Indemsys/Universal3PHalfBridgeController/Photos/Testing_w_motor.jpg

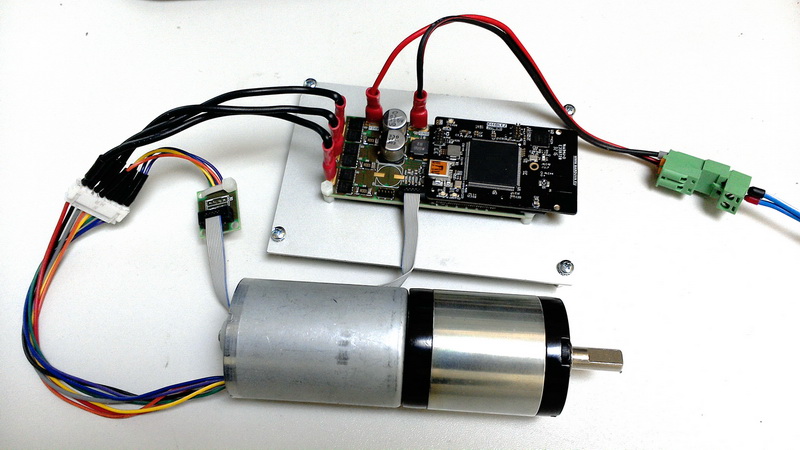
Photos/Testing_w_motor.jpg
