Indemsys/Universal3PHalfBridgeController/Docs/PCB_top.png

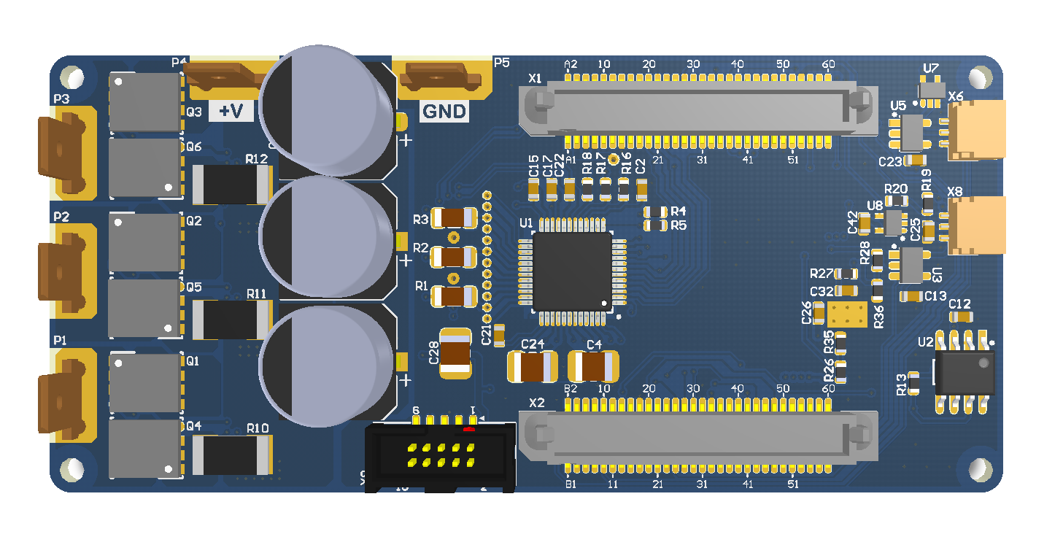
Docs/PCB_top.png
