Indemsys/Universal3PHalfBridgeController/README.md

# Universal3PHalfBridgeController
