Indemsys/Universal3PHalfBridgeController/Docs/PCB_bot.png

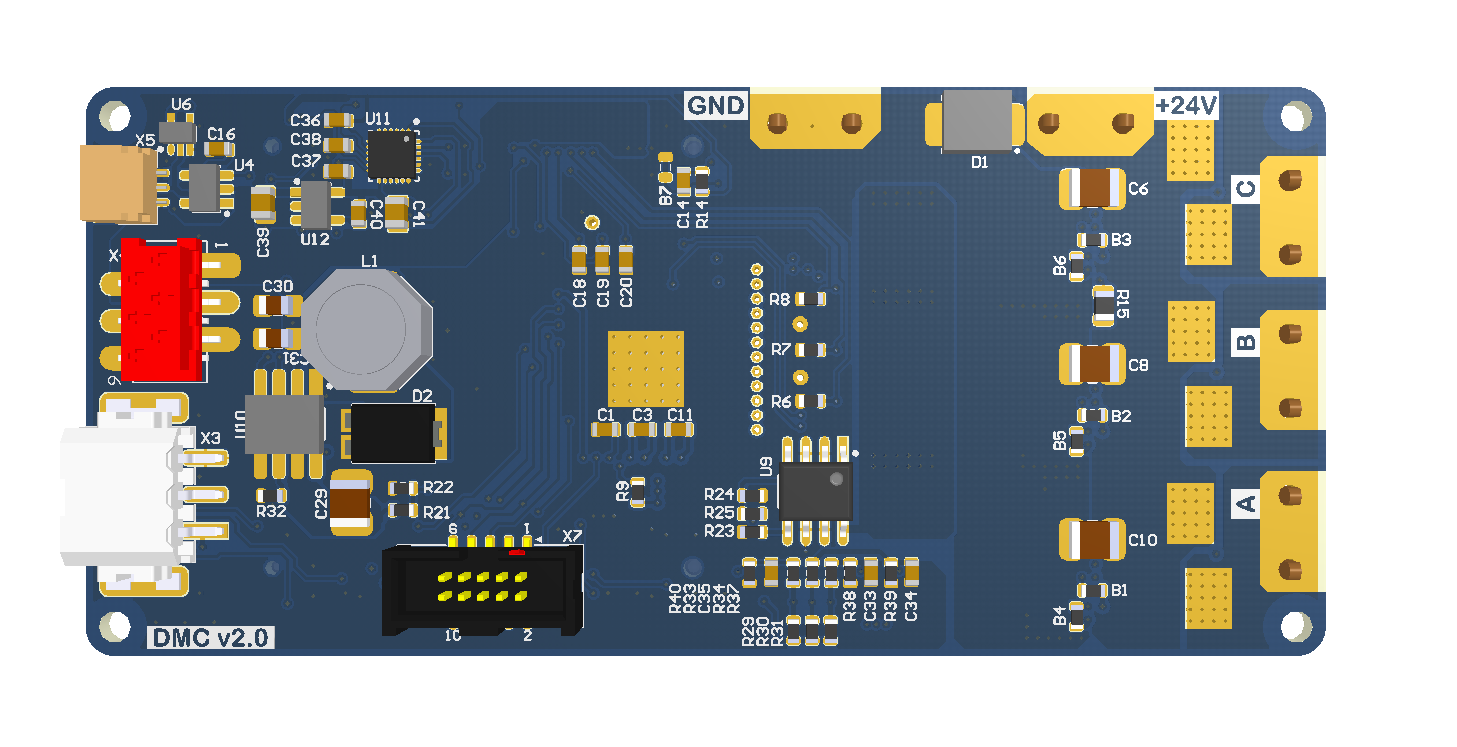
Docs/PCB_bot.png
