Indemsys/Universal3PHalfBridgeController/K66_Firmware/FreeMaster_apps/HTML/RotControl_Pic.jpg

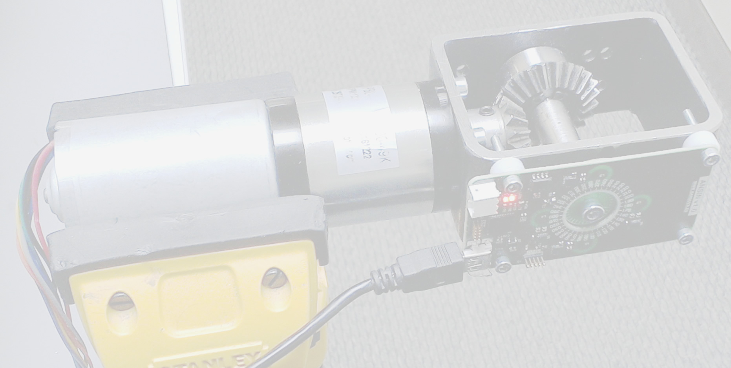
K66_Firmware/FreeMaster_apps/HTML/RotControl_Pic.jpg
