Indemsys/Universal3PHalfBridgeController/K66_Firmware/FreeMaster_apps/HTML/SolenoidControl_pic.jpg

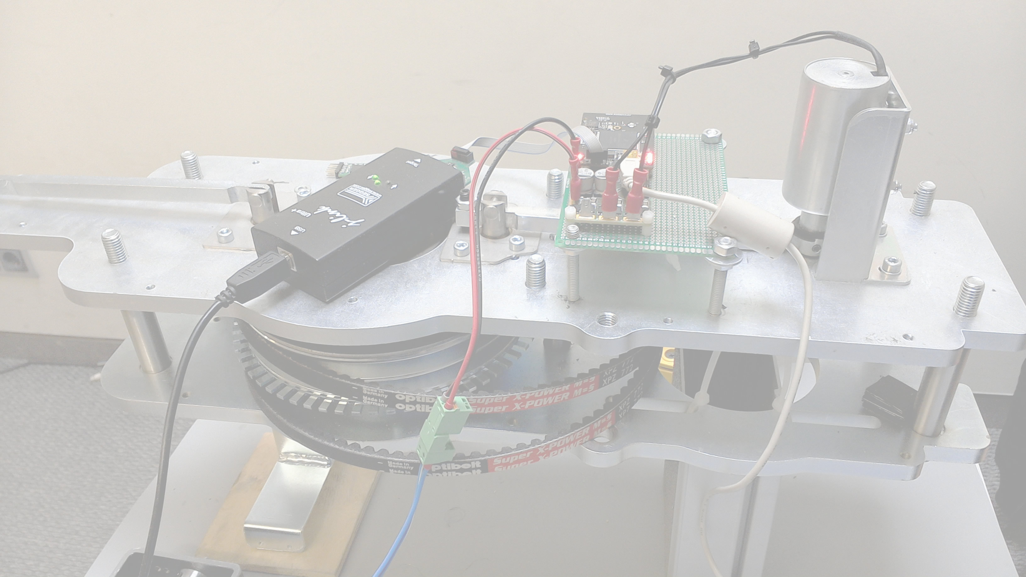
K66_Firmware/FreeMaster_apps/HTML/SolenoidControl_pic.jpg
