Indemsys/Universal3PHalfBridgeController/K66_Firmware/TESTS/MQX_benchmark/results.html

MQX Timing Report

Parameters

Board | K66BLEZ1 | Version | 4.2.0
CPU | MK66FX1M0VLQ18 180 MHz | Generic Revision | 23
Memory | 256K Internal SRAM | PSP Revision | 10
Target | Int Flash Debug RegABI | BSP Revision | 01
Compiler | IAR Embedded Workbench for ARM | IO Revision | 31
PSP build date | Apr 30 2017 at 12:20:00

Kernel Options

Has Code Cache | No | Has Data Cache | No
Kernel Log Support | Yes | Logging Enabled | No
Check Errors | Yes | Check Memory Allocation Errors | Yes
Check Validity | Yes | Component Destruction | Yes
Default Time Slice in Ticks | No | Exit Enabled | Yes
Has Time Slice | Yes | Include Floating Point I/O | Yes
Is Multiprocessor | Yes | LWLog Time Stamp in Ticks | No
Memory Free List Sorted | Yes | Monitor Stack | Yes
Mutex has Polling | Yes | Profiling Enabled | Yes
Run Time Error Check Enabled | Yes | Task Creation Blocks | Yes
Task Destruction | Yes | Time Uses Ticks Only | Yes
Use 32-bit Message Qids | No | Use 32-bit Types | No
Use Idle Task | Yes | Use Inline Macros | Yes
Use Lwmem Allocator | Yes

Resource Usage

Kernel RAM | 1012 | Memory Block | 12 + data
Message | 28 + data | Semaphore | 112
ISR | 12 * #ints | Partition | 12 + data
Msg Queue | 32 | Task | 220 + stack
Task Queue | 28 | Mutex | 48
Event | 92 | LWEvent | 36
LWSem | 28 | LWMem | 12

System Parameters

Context Switch

2.16us | 388.92us 1MHz
Service Interrupt and return to task

7.38ns | 1.33us 1MHz
System Timer/Tick Overhead

366.34ns | 65.94us 1MHz

Task Management

Create Task

16.74us | 3.01ms 1MHz
Delete Task

51.21us | 9.22ms 1MHz
Block Task

2.16us | 388.92us 1MHz
Ready Task

1.52us | 274.12us 1MHz
Yield Task

3.16us | 567.98us 1MHz

Task Queues

Suspend Task

3.68us | 663.18us 1MHz
Suspend Task Context Switch

2.89us | 519.54us 1MHz
Resume Task

1.83us | 329.98us 1MHz
Resume Task Context Switch

3.68us | 661.62us 1MHz

Memory Management

Allocate Memory

2.44us | 440.02us 1MHz
Free Memory

3.04us | 546.84us 1MHz
Allocate LW-Memory

2.11us | 378.98us 1MHz
Free LW-Memory

2.72us | 489.58us 1MHz

Partitions

Partition Create

2.89us | 519.82us 1MHz
Partition Allocate Block

1.41us | 253.26us 1MHz
Partition Free Block

1.22us | 218.82us 1MHz

Light Weight Semaphores

Open LW-Semaphore

2.89us | 520.10us 1MHz
Set LW-Semaphore

747.44ns | 134.54us 1MHz
Set LW-Semaphore Ready Task

1.79us | 322.70us 1MHz
Set LW-Semaphore Context Switch

3.56us | 640.76us 1MHz
Wait LW-Semaphore

1.06us | 189.98us 1MHz
Wait LW-Semaphore Block Task

2.99us | 538.86us 1MHz
Close LW-Semaphore

2.22us | 399.70us 1MHz

Light Weight Events

Open LW-Event

2.78us | 501.06us 1MHz
Close LW-Event

1.87us | 336.98us 1MHz
Wait LW-Event (ticks)

1.41us | 253.40us 1MHz
Set LW-Event

1.25us | 225.12us 1MHz
Set LW-Event Context Switch

4.04us | 727.28us 1MHz
Set LW-Event Ready Task

2.11us | 379.54us 1MHz
Wait LW-Event (ticks) Block Task

3.60us | 647.50us 1MHz

Message Passing

Open Message Queue

1.68us | 301.84us 1MHz
Send Message

2.53us | 455.14us 1MHz
Send Message Ready Task

2.59us | 466.76us 1MHz
Send Message Context Switch

4.43us | 798.12us 1MHz
Receive Message (ticks)

1.91us | 343.84us 1MHz
Receive Message (ticks) Block Task

3.07us | 552.30us 1MHz
Close Message Queue

1.80us | 323.40us 1MHz

Message Pools

Create Message Pool

5.45us | 980.56us 1MHz
Delete Message Pool

4.87us | 875.70us 1MHz
Allocate Message

1.25us | 225.12us 1MHz
Free Message

982.34ns | 176.82us 1MHz

Semaphores

Open Semaphore

6.65us | 1.20ms 1MHz
Open Semaphore Fast

5.05us | 909.86us 1MHz
Set Semaphore

1.91us | 343.98us 1MHz
Set Semaphore Ready Task

4.14us | 745.50us 1MHz
Set Semaphore Context Switch

4.61us | 828.92us 1MHz
Wait Semaphore (ticks)

1.52us | 273.84us 1MHz
Wait Semaphore (ticks) Block Task

3.54us | 636.30us 1MHz
Close Semaphore

4.28us | 770.84us 1MHz

Events

Open Event

7.12us | 1.28ms 1MHz
Open Event Fast

4.87us | 876.26us 1MHz
Set Event

1.75us | 315.84us 1MHz
Set Event Ready Task

2.57us | 462.70us 1MHz
Set Event Context Switch

4.61us | 828.92us 1MHz
Wait Event (ticks)

1.49us | 267.40us 1MHz
Wait Event (ticks) Block Task

3.23us | 582.26us 1MHz
Close Event

4.15us | 747.18us 1MHz

Mutexes

Open Mutex

3.32us | 596.82us 1MHz
Unlock Mutex

867.22ns | 156.10us 1MHz
Unlock Mutex Ready Task

1.80us | 323.82us 1MHz
Unlock Mutex Context Switch

3.91us | 703.20us 1MHz
Lock Mutex

1.56us | 280.98us 1MHz
Lock Mutex Block Task

3.48us | 626.36us 1MHz
Close Mutex

3.86us | 694.12us 1MHz

(c) 2009 Freescale Semiconductor. All rights reserved. Confidential Information. No part of this document may be copied or reproduced in any form or by any means without prior written consent of Freescale Semiconductor. Freescale MQX is a trademark of Freescale Semiconductor. All other trademarks are property of their respective owners.
