Indemsys/Universal3PHalfBridgeController/(list of files, drawings)

Other design files:
SCH_PCB/DMC02.PrjPcb
SCH_PCB/Sheet1.SchDoc
SCH_PCB/Sheet2.SchDoc
