Indemsys/Universal3PHalfBridgeController/K66_Firmware/ParametersManager/grids.ini

[Main]
Version=2

[frmMain.grid_Params_View: TcxGridDBTableView]
=
Footer="True"
GroupByBox="True"
GroupFooters=0
NewItemRow="False"
EditFormUseDefaultLayout="True"
Version=1

[frmMain.grid_Params_View/grid_Params_ViewID: TcxGridDBColumn]
=
GroupIndex=-1
Width=20
AlignmentHorz=1
Index=0
Visible="False"
SortOrder="soNone"
SortIndex=-1
WasVisibleBeforeGrouping="False"

[frmMain.grid_Params_View/grid_Params_Viewparmnlev: TcxGridDBColumn]
=
GroupIndex=0
Width=213
AlignmentHorz=0
Index=1
Visible="False"
SortOrder="soAscending"
SortIndex=0
WasVisibleBeforeGrouping="True"

[frmMain.grid_Params_View/grid_Params_ViewSeqNum: TcxGridDBColumn]
=
GroupIndex=-1
Width=34
AlignmentHorz=1
Index=2
Visible="True"
SortOrder="soAscending"
SortIndex=1
WasVisibleBeforeGrouping="False"

[frmMain.grid_Params_View/grid_Params_Viewpname: TcxGridDBColumn]
=
GroupIndex=-1
Width=194
AlignmentHorz=0
Index=3
Visible="True"
SortOrder="soNone"
SortIndex=-1
WasVisibleBeforeGrouping="False"

[frmMain.grid_Params_View/grid_Params_Viewval: TcxGridDBColumn]
=
GroupIndex=-1
Width=71
AlignmentHorz=0
Index=4
Visible="True"
SortOrder="soNone"
SortIndex=-1
WasVisibleBeforeGrouping="False"

[frmMain.grid_Params_View/grid_Params_Viewvartype: TcxGridDBColumn]
=
GroupIndex=-1
Width=42
AlignmentHorz=0
Index=5
Visible="True"
SortOrder="soNone"
SortIndex=-1
WasVisibleBeforeGrouping="False"

[frmMain.grid_Params_View/grid_Params_Viewdefval: TcxGridDBColumn]
=
GroupIndex=-1
Width=113
AlignmentHorz=1
Index=6
Visible="True"
SortOrder="soNone"
SortIndex=-1
WasVisibleBeforeGrouping="False"

[frmMain.grid_Params_View/grid_Params_Viewminval: TcxGridDBColumn]
=
GroupIndex=-1
Width=87
AlignmentHorz=1
Index=7
Visible="True"
SortOrder="soNone"
SortIndex=-1
WasVisibleBeforeGrouping="False"

[frmMain.grid_Params_View/grid_Params_Viewmaxval: TcxGridDBColumn]
=
GroupIndex=-1
Width=71
AlignmentHorz=1
Index=8
Visible="True"
SortOrder="soNone"
SortIndex=-1
WasVisibleBeforeGrouping="False"

[frmMain.grid_Params_View/grid_Params_Viewabbreviation: TcxGridDBColumn]
=
GroupIndex=-1
Width=61
AlignmentHorz=0
Index=9
Visible="True"
SortOrder="soNone"
SortIndex=-1
WasVisibleBeforeGrouping="False"

[frmMain.grid_Params_View/grid_Params_Viewattr: TcxGridDBColumn]
=
GroupIndex=-1
Width=20
AlignmentHorz=0
Index=10
Visible="True"
SortOrder="soNone"
SortIndex=-1
WasVisibleBeforeGrouping="False"

[frmMain.grid_Params_View/grid_Params_Viewpdefval: TcxGridDBColumn]
=
GroupIndex=-1
Width=64
AlignmentHorz=0
Index=11
Visible="True"
SortOrder="soNone"
SortIndex=-1
WasVisibleBeforeGrouping="False"

[frmMain.grid_Params_View/grid_Params_Viewformat: TcxGridDBColumn]
=
GroupIndex=-1
Width=20
AlignmentHorz=0
Index=12
Visible="True"
SortOrder="soNone"
SortIndex=-1
WasVisibleBeforeGrouping="False"

[frmMain.grid_Params_View/grid_Params_Viewfunc: TcxGridDBColumn]
=
GroupIndex=-1
Width=20
AlignmentHorz=0
Index=13
Visible="True"
SortOrder="soNone"
SortIndex=-1
WasVisibleBeforeGrouping="False"

[frmMain.grid_Params_View/grid_Params_Viewvarlen: TcxGridDBColumn]
=
GroupIndex=-1
Width=20
AlignmentHorz=1
Index=14
Visible="True"
SortOrder="soNone"
SortIndex=-1
WasVisibleBeforeGrouping="False"

[frmMain.grid_Params_View/grid_Params_ViewpublicMIB: TcxGridDBColumn]
=
GroupIndex=-1
Width=20
AlignmentHorz=0
Index=15
Visible="True"
SortOrder="soNone"
SortIndex=-1
WasVisibleBeforeGrouping="False"

[grid_ParamsTree.grid_ParamsTree: TcxDBTreeList]
=

[grid_ParamsTree.grid_ParamsTree/Bands: TcxTreeListBands]
=

[grid_ParamsTree.grid_ParamsTree/Bands/Band0: TcxTreeListBand]
=
Caption=""
RealMinWidth=20
RealWidth=0
Visible="True"
Index=0
BandIndex=-1
ColIndex=0

[grid_ParamsTree.grid_ParamsTree/grid_ParamsTreeID: TcxDBTreeListColumn]
=
Visible="False"
Index=0
LineCount=1
ColIndex=1
RowIndex=0
BandIndex=0
Caption="ID"
SortOrder="soNone"
SortIndex=-1
RealMinWidth=20
RealWidth=91

[grid_ParamsTree.grid_ParamsTree/grid_ParamsTreeParent: TcxDBTreeListColumn]
=
Visible="False"
Index=1
LineCount=1
ColIndex=2
RowIndex=0
BandIndex=0
Caption="Parent"
SortOrder="soNone"
SortIndex=-1
RealMinWidth=20
RealWidth=100

[grid_ParamsTree.grid_ParamsTree/grid_ParamsTreeCategoryName: TcxDBTreeListColumn]
=
Visible="True"
Index=2
LineCount=1
ColIndex=0
RowIndex=0
BandIndex=0
Caption="Имя подгруппы"
SortOrder="soNone"
SortIndex=-1
RealMinWidth=20
RealWidth=218

[grid_ParamsTree.grid_ParamsTree/grid_ParamsTreeDescription: TcxDBTreeListColumn]
=
Visible="True"
Index=3
LineCount=1
ColIndex=3
RowIndex=0
BandIndex=0
Caption="Описание"
SortOrder="soNone"
SortIndex=-1
RealMinWidth=20
RealWidth=175

[grid_ParamsTree.grid_ParamsTree/grid_ParamsTreeShortDescription: TcxDBTreeListColumn]
=
Visible="True"
Index=4
LineCount=1
ColIndex=6
RowIndex=0
BandIndex=0
Caption="Короткое описание"
SortOrder="soNone"
SortIndex=-1
RealMinWidth=255
RealWidth=255

[grid_ParamsTree.grid_ParamsTree/grid_ParamsTreeComment: TcxDBTreeListColumn]
=
Visible="True"
Index=5
LineCount=1
ColIndex=7
RowIndex=0
BandIndex=0
Caption="Комментарии"
SortOrder="soNone"
SortIndex=-1
RealMinWidth=20
RealWidth=265

[grid_ParamsTree.grid_ParamsTree/grid_ParamsTreeProfileID: TcxDBTreeListColumn]
=
Visible="False"
Index=6
LineCount=1
ColIndex=5
RowIndex=0
BandIndex=0
Caption="ProfileID"
SortOrder="soNone"
SortIndex=-1
RealMinWidth=20
RealWidth=81

[grid_ParamsTree.grid_ParamsTree/grid_ParamsTreeOIDName: TcxDBTreeListColumn]
=
Visible="True"
Index=7
LineCount=1
ColIndex=4
RowIndex=0
BandIndex=0
Caption="Имя OID в MIB базе"
SortOrder="soNone"
SortIndex=-1
RealMinWidth=20
RealWidth=165

[grid_ParamsTree.grid_ParamsTree/grid_ParamsTreeVisible: TcxDBTreeListColumn]
=
Visible="True"
Index=8
LineCount=1
ColIndex=8
RowIndex=0
BandIndex=0
Caption="Visible"
SortOrder="soNone"
SortIndex=-1
RealMinWidth=20
RealWidth=0

[frmMain.grid_Profiles_View: TcxGridDBTableView]
=
Footer="False"
GroupByBox="False"
GroupFooters=0
NewItemRow="False"
EditFormUseDefaultLayout="True"
Version=1

[frmMain.grid_Profiles_View/grid_Profiles_ViewProfileName: TcxGridDBColumn]
=
GroupIndex=-1
Width=294
AlignmentHorz=0
Index=0
Visible="True"
SortOrder="soAscending"
SortIndex=0
WasVisibleBeforeGrouping="False"

[frmMain.grid_Profiles_View/grid_Profiles_ViewDescription: TcxGridDBColumn]
=
GroupIndex=-1
Width=788
AlignmentHorz=0
Index=1
Visible="True"
SortOrder="soNone"
SortIndex=-1
WasVisibleBeforeGrouping="False"
