Indemsys/Universal3PHalfBridgeController/K66_Firmware/MQX_SRC/mqx/source/io/lwgpio/lwgpio.h

/*HEADER**********************************************************************
*
* Copyright 2010-2011 Freescale Semiconductor, Inc.
*
* This software is owned or controlled by Freescale Semiconductor.
* Use of this software is governed by the Freescale MQX RTOS License
* distributed with this Material.
* See the MQX_RTOS_LICENSE file distributed for more details.
*
* Brief License Summary:
* This software is provided in source form for you to use free of charge,
* but it is not open source software. You are allowed to use this software
* but you cannot redistribute it or derivative works of it in source form.
* The software may be used only in connection with a product containing
* a Freescale microprocessor, microcontroller, or digital signal processor.
* See license agreement file for full license terms including other
* restrictions.
*****************************************************************************
*
* Comments:
*
*   The file contains definitions used in user program and/or in other
*   kernel modules to access GPIO pins
*
*
*END************************************************************************/
#ifndef __lwgpio_h__
#define __lwgpio_h__ 1

#include <mqx.h>

#ifdef __cplusplus
extern "C" {
#endif

/* Type holding pin ID */
typedef uint32_t LWGPIO_PIN_ID;

/* Type holding pin direction */
typedef enum {
    LWGPIO_DIR_INPUT,
    LWGPIO_DIR_OUTPUT,
    /* special value; for function parameters it means that value should not be changed */
    LWGPIO_DIR_NOCHANGE
} LWGPIO_DIR; 

/* Type holding pin value */
typedef enum {
    LWGPIO_VALUE_LOW,
    LWGPIO_VALUE_HIGH,
    /* special value; for function parameters it means that value should not be changed */
    LWGPIO_VALUE_NOCHANGE
} LWGPIO_VALUE;

/* Type identifying pin interrupt mode */
#ifndef LWGPIO_INT_MODE_NONE
    #define LWGPIO_INT_MODE_NONE    (0x00)
#endif
#ifndef LWGPIO_INT_MODE_RISING
    #define LWGPIO_INT_MODE_RISING  (0x01)
#endif
#ifndef LWGPIO_INT_MODE_FALLING
    #define LWGPIO_INT_MODE_FALLING (0x02)
#endif
#ifndef LWGPIO_INT_MODE_HIGH
    #define LWGPIO_INT_MODE_HIGH    (0x04)
#endif
#ifndef LWGPIO_INT_MODE_LOW
    #define LWGPIO_INT_MODE_LOW     (0x08)
#endif

/* Pin attributes*/
#define LWGPIO_ATTR_PULL_UP         (1)
#define LWGPIO_ATTR_PULL_DOWN       (2)
#define LWGPIO_ATTR_OPEN_DRAIN      (3)

/*attributes value*/
#define LWGPIO_AVAL_ENABLE          (1)
#define LWGPIO_AVAL_DISABLE         (0)

typedef unsigned char LWGPIO_INT_MODE;

bool lwgpio_init(LWGPIO_STRUCT_PTR, LWGPIO_PIN_ID, LWGPIO_DIR, LWGPIO_VALUE);
void lwgpio_set_functionality(LWGPIO_STRUCT_PTR, uint32_t);
bool lwgpio_set_attribute(LWGPIO_STRUCT_PTR, uint32_t, uint32_t);
uint32_t lwgpio_get_functionality(LWGPIO_STRUCT_PTR);
void lwgpio_set_direction(LWGPIO_STRUCT_PTR, LWGPIO_DIR);
void lwgpio_set_value(LWGPIO_STRUCT_PTR, LWGPIO_VALUE);
void lwgpio_toggle_value(LWGPIO_STRUCT_PTR);
LWGPIO_VALUE lwgpio_get_value(LWGPIO_STRUCT_PTR);
LWGPIO_VALUE lwgpio_get_raw(LWGPIO_STRUCT_PTR);

bool lwgpio_int_init(LWGPIO_STRUCT_PTR, LWGPIO_INT_MODE);
uint32_t lwgpio_int_get_vector(LWGPIO_STRUCT_PTR);
void lwgpio_int_enable(LWGPIO_STRUCT_PTR, bool);
bool lwgpio_int_get_flag(LWGPIO_STRUCT_PTR);
void lwgpio_int_clear_flag(LWGPIO_STRUCT_PTR);

extern bool lwgpio_set_pin_output(LWGPIO_PIN_ID, LWGPIO_VALUE);
extern bool lwgpio_toggle_pin_output(LWGPIO_PIN_ID);
extern LWGPIO_VALUE lwgpio_get_pin_input(LWGPIO_PIN_ID);

#ifdef __cplusplus
}
#endif

#endif /* __lwgpio_h__ */
