Indemsys/Universal3PHalfBridgeController/K66_Firmware/ParametersManager/EMBPMAN.ini

[Main]
Version=2

[frmMain: TcxPropertiesStoreComponent]
=
Height=872
Left=226
Top=108
Width=1112

[grid_ParamsTree: TcxPropertiesStoreComponent]
=
Height=254

[grid_Profiles: TcxPropertiesStoreComponent]
=
Height=119
