Indemsys/Universal3PHalfBridgeController/K66_Firmware/APP_SRC/App_logger.c

#include "App.h"


#define       FILE_LOG_MSG_CNT  64


T_app_log_record       app_log[EVENT_LOG_SIZE];

typedef struct
{
  // Переменные лога событий
  uint32_t       event_log_head;
  uint32_t       event_log_tail;

  unsigned int sync_err;
  unsigned int overl_err;

} T_app_log_cbl;

#define MAX_LOG_FILENAME_SZ 32
#define LOG_FILE_NAME DISK_NAME"AppLog.txt"
typedef struct
{
  char         log_file_name[MAX_LOG_FILENAME_SZ + 1];
  unsigned int queue_err;
  unsigned int alloc_err;

} T_file_log_cbl;



static T_app_log_cbl    log_cbl;
static LWSEM_STRUCT     log_sem;

static T_file_log_cbl   flog_cbl; // Управляющая структура файлового лога

static uint32_t file_log_queue[sizeof(LWMSGQ_STRUCT)/sizeof(uint32_t)+ FILE_LOG_MSG_CNT * sizeof(void*)];

static uint8_t  pend_params_saving;
/*-----------------------------------------------------------------------------------------------------

-----------------------------------------------------------------------------------------------------*/
_mqx_uint AppLogg_init(void)
{
  _mqx_uint res = MQX_OK;
  if (_lwsem_create(&log_sem, 1) != MQX_OK) res = MQX_ERROR;

  // Создаем очередь сообщений для лога на SD карту
  if  (_lwmsgq_init((void *)file_log_queue, FILE_LOG_MSG_CNT, sizeof(void *)) != MQX_OK) res = MQX_ERROR;


  return res;
}

/*------------------------------------------------------------------------------
  Функция передачи лога в задачу сохранения лога в файл


 \return _mqx_uint
 ------------------------------------------------------------------------------*/
static _mqx_uint _write_log_to_file(char *str, const char *func_name, unsigned int line_num, unsigned int severity)
{
  T_app_log_record *plrec;
  // Выделяем память для структуры с содержимым полей сообщения

  plrec = (T_app_log_record *)_mem_alloc_system_zero(sizeof(T_app_log_record));
  if (plrec != NULL)
  {
    plrec->line_num = line_num;
    plrec->severity = severity;
    strncpy(plrec->msg, str, LOG_STR_MAX_SZ);
    strncpy(plrec->func_name, func_name, EVNT_LOG_FNAME_SZ);
    _time_get(&(plrec->time));

    if (_lwmsgq_send((void *)file_log_queue, (uint32_t *)&plrec, 0) != MQX_OK)
    {
      // Если послать не удалось освобождаем память сообщения
      _mem_free(plrec);
      flog_cbl.queue_err++;
      return MQX_ERROR;
    }
    return MQX_OK;
  }
  else
  {
    flog_cbl.alloc_err++;
    return MQX_ERROR;
  }
}
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
